mikeferguson/maxwell/README.md

## Maxwell
Maxwell is a custom mobile manipulator based on the Etherbotix
(earlier versions were based on the ArbotiX RoboController).

Documentation can be found at http://ros.org/wiki/maxwell
