mikeferguson/maxwell/maxwell/docs/lasercut/README.md

# Revision History

 * Rev. A (January 2011)
   * This is a minor revision over the original design, so that the
     front panel can drop down.
 * Rev. B (October 2014)
   * Add front panel mounts for Etherbotix, power board, torso driver.
   * Add finger holes to front panel.
   * Remove terminal block holes in bottom.
