mikeferguson/maxwell/maxwell/docs/bom.md

# Maxwell Parts List

## Purchased Components

Components for the mobile base:

Line|Qty | Description                        | Est. Cost | Notes / Vendor
----|----|------------------------------------|-----------|-------
1   |1   | Drive motors, casters, encoder cables | $309.95 | Only the motors, encoders, and casters are used. Be sure to select the 2X speed option and also add the HEDS5500 encoder cables. [Zagros Robotics](http://www.zagrosrobotics.com/shop/item.aspx?itemid=529)
2   |2   | Drive wheel | $6.80 | Any of the three colors will do. [Banebots](http://banebots.com/c/WHB-HS4-498)
3   |2   | Hub, hex, 6mm bore | $4.50 | These are 6mm and will need to be bored out to 1/4" to match motors above. [Banebots](http://banebots.com/pc/WHB-HM-HS4-M6/T40H-SM62)
4   |4   | 1/4-20 x 1-1/2" Hex Standoff | $2.02 | Used to attach caster to base. [McMaster](http://www.mcmaster.com/#91780a974/=u4mzp8)
5   |1   | UB1280 12V 8AH SLA | ~$20 | Available from Amazon among others.
6   |1   | Motor driver | $59.95 | Motor driver plugs into Etherbotix. [Pololu](http://www.pololu.com/product/708)
7   |1   | Mini-IMU9 | $19.95 | IMU, plugs into Etherbotix. [Pololu](http://www.pololu.com/product/2468)
8   |1   | Torso motor driver | $27.95 | Used for torso lift. [Pololu](http://www.pololu.com/product/705)
9   |1   | Power switch DPDT | $3.99 | [Radio Shack](http://www.radioshack.com/product/index.jsp?productId=2062518)
10  |1   | 12V snap in blue bulb | 2.99 | [Radio Shack](http://www.radioshack.com/product/index.jsp?productId=2062368)
11  |1   | Size M Charge inlet | $3.49 | [Radio Shack](http://www.radioshack.com/product/index.jsp?productId=2102486). Charge block needs to be reterminated with [Size M DC Plug](http://www.radioshack.com/product/index.jsp?productId=2103614).
12  |1   | Size N Power inlet | $3.49 | 2.5mm I.D. power jack. Matches bioloid power brick. [Radio Shack](http://www.radioshack.com/product/index.jsp?productId=2102489)
13  |18  | 4-40 right angle bracket | $6 total | These are used to assemble the base. [Digikey](http://www.digikey.com/product-search/en/hardware-fasteners-accessories/mounting-brackets/2097394?k=621K-nd)
14  |48  | 4-40 x 1/4" SHCS | $4.35 (100pk) | (24) Used to assemble base. (22) To mount Etherbotix, etc. (2) for runstop bracket. [Lynxmotion](http://www.lynxmotion.com/p-135-steel-socket-head-screws-14-x-4-40-100.aspx)
15  |12  | 4-40 x 3/8" SHCS | $4.85 (100pk) | (12) Used to attach top of base. [Lynxmotion](http://www.lynxmotion.com/p-136-steel-socket-head-screws-38-x-4-40-100.aspx)
16  |4   | 4-40 x 5/8" SHCS | $5.85 (100pk) | Used to install upright holder to base. [Lynxmotion](http://www.lynxmotion.com/p-138-steel-socket-head-screws-58-x-4-40-100.aspx)
17  |4   | 4-40 Machine Screw Nut | $0.81 (100pk) | Used to install upright holder to base. [McMaster](http://www.mcmaster.com/#90480a005/=u4n2oa)
18  |4   | 4-40 Lock Washer | $2.29 (100pk) | Used to install upright holder to base. [McMaster](http://www.mcmaster.com/#95584a200/=u4n3cc)
19  |11  | 3/8" 4-40 Standoff | $4.85 (10pk) | (4) Used to mount Etherbotix, (4) for power board and (3) for torso motor driver. [Lynxmotion](http://www.lynxmotion.com/p-152-nylon-hex-standoffs-f-f-38-x-14-4-40-tapped-10.aspx)

Components for the Torso and Head:

Line|Qty | Description                        | Est. Cost | Notes / Vendor
----|----|------------------------------------|-----------|-------
20  |1   | 20" Linear actuator| $119.99 | Torso lift actuator. [Firgelli](http://www.firgelliauto.com/product_info.php?cPath=118&products_id=255)
21  |2   | Actuator mount | $7.00 | Only bracket is used, hardware is replaced. [Firgelli](http://www.firgelliauto.com/product_info.php?products_id=54)
22  |2   | 1/4-20 x 1.5" Bolt w/ Nut | ??? | For attaching linear actuator to mounts.
23  |2   | 8020 1010x36 T Slot Aluminum Extrusion | ~$10 | The 8020 Ebay store can be a good place to buy this and other 8020 components. The bottom piece will be un-cut, 36" long. The top piece used for Maxwell's torso will need to be cut to 14" long.
24  |2   | 8020 Corner Bracket P/N 4108 | $2.75 | Used to hold torso upright.
25  |1   | 8020 Joining Strip P/N 4117 | $5 | Attaches upper and lower 8020 sections.
26  |1   | 8020 3/8" Bolt, T Nuts (25) P/N 3386 | $11.50 | (2) for corner bracket upright portion, (4) for joining plate, (2) for mounting linear actuator.
27  |1   | 8020 1/2" Bolt, T Nuts (25) P/N 3321 | $12.50 | (4) for mounting estop assembly, (8) for mounting caster
28  |6   | 1/4-20 x 5/8" Bolt | ? | (4) for head, (2) for base.
29  |2   | 1/4-20 Nut | ? | (2) used to attach corner bracket 4108 to base.
30  |1   | Run stop switch | $27.30 | [Digikey](http://www.digikey.com/product-search/en?Cat=1114209&k=Z1504-ND)
31  |1   | 1.25"L 4-40 Standoff | ? | Holds runstop bracket together.
32  |1   | Bioloid F2 | $1.49 | Used in head tilt. [Trossen Robotics](http://www.trossenrobotics.com/store/p/6180-Bioloid-Frame-F2.aspx)
33  |7   | Bioloid F3 | $1.49 | (2) used to attach head pan servo to neck brackets, (1) used to attach pan and tilt servos, (4) used in gripper. [Trossen Robotics](http://www.trossenrobotics.com/store/p/6181-Bioloid-Frame-F3.aspx)
34  |1   | ASUS Xtion Pro Live | $169.99 | Head sensor. [Newegg](http://www.newegg.com/Product/Product.aspx?Item=N82E16826785030)

Components for the Arm:

Line|Qty | Description                        | Est. Cost | Notes / Vendor
----|----|------------------------------------|-----------|-------
35  |3   | Dynamixel AX-12 | $44.90 | (2) in head, (1) for wrist roll. [Trossen Robotics](http://www.trossenrobotics.com/dynamixel-ax-12-robot-actuator.aspx)
36  |5   | Dynamixel MX-64T | $299.90 | Used in arm. [Trossen Robotics](http://www.trossenrobotics.com/p/mx-64t-dynamixel-robot-actuator.aspx)
37  |1   | FR05-H101K | $29.90 | Hinge kit used for wrist flex. [Trossen Robotics](http://www.trossenrobotics.com/p/Robotis-Dynamixel-FR05-H101K-Hinge-Frame-Set.aspx)
38  |2   | HN05-I101 Idler | $15.40 | Needed for upper arm MX-64 servos. [Trossen Robotics](http://www.trossenrobotics.com/p/Robotis-Dynamixel-HN05-I101-Idler-Bearing-Set.aspx)
39  |3   | FR05-S101K Side Frame | $14.90 | Used for arm pan. [Trossen Robotics](http://www.trossenrobotics.com/p/Robotis-Dynamixel-FR05-S101K-Side-Frame-Set.aspx)
40  |4   | 8020 White Unibearing Pad 6705 | $3.00 | Support bearings for the arm trolley.
41  |8   | 10-32 Flat Head, 3/4"L | ??? | Used to attach support bearings to laser cut arm trolley parts.
42  |2   | M5 x 8mm SHCS | $5.95 (50pk) | Used to attach arm trolley to linear actuator. [McMaster](http://www.mcmaster.com/#91274a125/=u4n45c)
??  |2   | 1-1/2"L 4-40 Standoff | ? | Holds trolley sides together on backside of torso.

The following parts are components of the Gen 1 gripper:

Line|Qty | Description                        | Est. Cost | Notes / Vendor
----|----|------------------------------------|-----------|-------
43  |2   | Dynamixel AX-12 | $44.90 ea. | One servo for each finger. [Trossen Robotics](http://www.trossenrobotics.com/dynamixel-ax-12-robot-actuator.aspx)
44  |2   | Bioloid F1 | $1.49 | Used in gripper. [Trossen Robotics](http://www.trossenrobotics.com/store/p/6179-Bioloid-Frame-F1.aspx)
45  |2   | Bioloid F6 | $1.49 ea. | Used to attach to wrist roll. [Trossen Robotics](http://www.trossenrobotics.com/store/p/6184-Bioloid-Frame-F6.aspx)
46  |2   | Bioloid F9 | $1.49 ea. | Used in fingers. [Trossen Robotics](http://www.trossenrobotics.com/store/p/6187-Bioloid-Frame-F9.aspx)
47  |2   | Bioloid F11 | $1.49 ea. | Used in fingers. [Trossen Robotics](http://www.trossenrobotics.com/store/p/6189-Bioloid-Frame-F11.aspx)

Optional components (or use your own wiring):

Line|Qty | Description                        | Est. Cost | Notes
----|----|------------------------------------|-----------|-------
49  |1   | Jumper wires F-F | $12.49 | Recommended way of easily connecting torso lift motor controller to Etherbotix. [Pololu](http://www.pololu.com/product/1700)
49  |18  | Wire Pin Connectors | $0.28 | Recommended for terminating wires into terminal blocks. [Digikey](http://www.digikey.com/scripts/DkSearch/dksus.dll?Detail&itemSeq=158992935)
50  |1   | 16ga Wire, 25ft (black) | $5.20 | For power wiring. [Home Depot](http://www.homedepot.com/p/Southwire-25-ft-16-Gauge-Primary-Wire-Black-55666621/202316512)
51  |1   | 16ga Wire, 25ft (white) | $5.20 | For power wiring. [Home Depot](http://www.homedepot.com/p/Southwire-25-ft-16-Gauge-Primary-Wire-White-55667921/202316509)
52  |1   | Long dynamixel wire (length?) | ? | For arm
53  |1   | Long dynamixel wire (length?) | ? | For head

## Custom Components

The Etherbotix is not currently available from retailers, but is entirely open source.
Cost of parts is approximately $60 plus PCB.

Similarly, the power board is not currently retailed, but is open source. It is very easy
to assemble. The PCB is less than 5x5cm, meeting the requirements for the cheapest
board options at Seeedstudio and others. Parts list for the power board is:

Qty | Description                        | Est. Cost | Notes / Vendor
----|------------------------------------|-----------|-------
1   | Maxwell Power Board                | 5.00      | Bare PCB
1   | Terminal Block 2P, Orange          | 0.55      | Digikey 281-2888-ND
1   | Terminal Block 2P, Black           | 0.55      | Digikey 281-1882-ND
1   | Terminal Block 3P, Orange          | 0.77      | Digikey 281-2882-ND
1   | Terminal Block 3P, Black           | 0.77      | Digikey 281-1883-ND 
1   | (optional) 19V regulator for NUC   | $16.95    | [Pololu](http://www.pololu.com/product/2571)
1   | (optional) Size N DC Power Plug | $3.99 | Matches power plug on NUC. [Radio Shack](http://www.radioshack.com/product/index.jsp?productId=2102488)

Finally, there are a number of laser cut and 3d printed components. The 3d printed
components include:

Qty | Description           | Filename or link  | Notes
----|-----------------------|-------------------|--------
1   | Upper arm bracket long | upper_arm_bracket_long.stl | Used between shoulder lift and upper arm roll servos.
1   | Upper arm bracket | upper_arm_bracket.stl | Used between upper arm roll and elbow flex servos.
1   | Head sensor mount | head_sensor_mount.stl | Mounts Asus to bioloid hinge bracket.
1   | Torso lift photointerrupter flag | ? | Snaps onto linear actuator screw, rotates through photointerrupter.
1   | Torso lift photointerrupter mount | ? | Holds photointerrupter into opening in side of linear actuator.

Laser cut components are split into 3 sheets, one each in 1/8", 3/16" and 1/4"
thickness, which should all be cut from ABS.

The 1/8" sheet contains:
 * 1 - Left neck side
 * 1 - Right neck side
 * 1 - Left runstop side
 * 1 - Right runstop side
 * 2 - Runstop spacer
 * 1 - Runstop mount plate
 * 2 - Forearm side panel
 * 2 - Gripper joining plate
 * 2 - Arm lift spacer

The 3/16" sheet contains:
 * 2 - Arm lift mounting plate
 * 2 - Arm lift servo mounting plate
 * 1 - Base front panel
 * 1 - Base left side
 * 1 - Base right side
 * 1 - Base rear panel

The 1/4" sheet contains:
 * 1 - Left neck spacer
 * 1 - Right neck spacer
 * 1 - Base top plate
 * 1 - Base upright holder
