mikeferguson/maxwell/maxwell/docs/lasercut/3_16.dxf

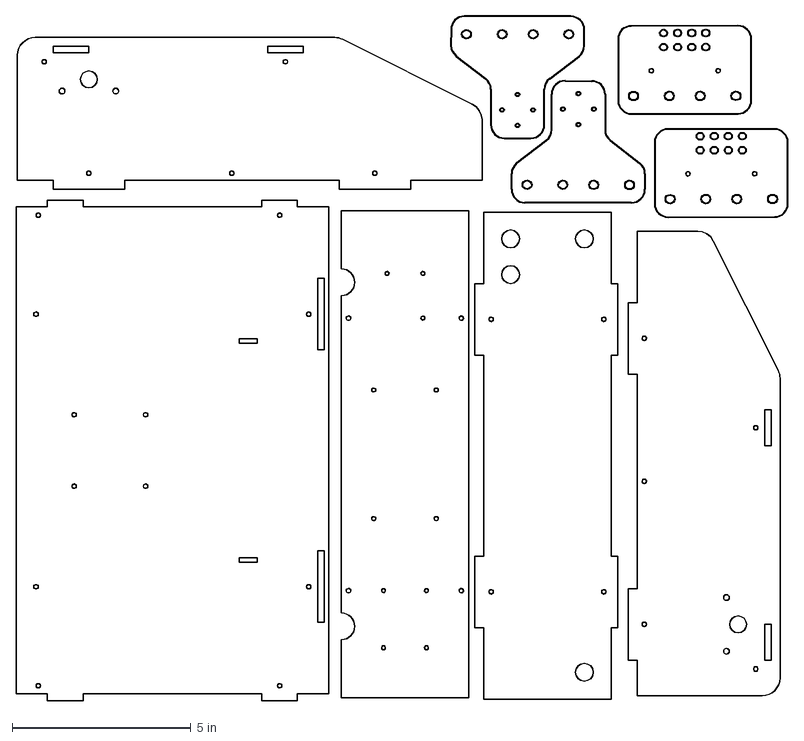
[picture p1: CAD file, 2015-01-01]
maxwell/docs/lasercut/3_16.dxf
21.6 x 19.1 in
