mikeferguson/maxwell/maxwell/docs/printed/rotary_interrupter.stl

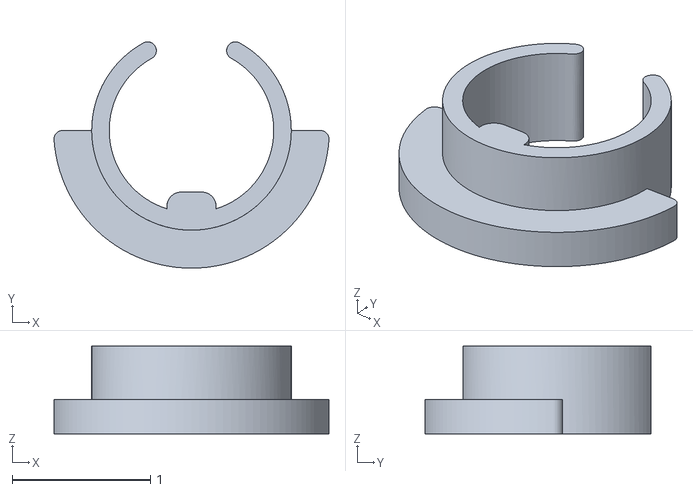
[picture p2: CAD file, 2015-03-03]
maxwell/docs/printed/rotary_interrupter.stl
1.99 x 1.64 x 0.635
