mikeferguson/maxwell/maxwell/meshes/sixdof_bracket2.stl

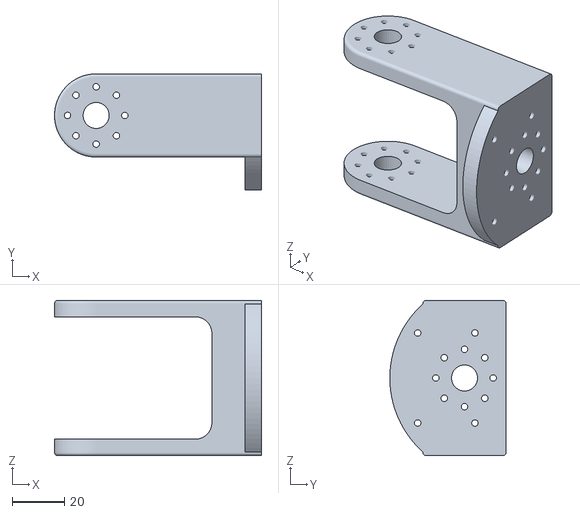
[picture p3: CAD file, 2013-02-20]
maxwell/meshes/sixdof_bracket2.stl
79.5 x 44.7 x 59.7
