mikeferguson/maxwell/maxwell/docs/lasercut/1_8.dxf

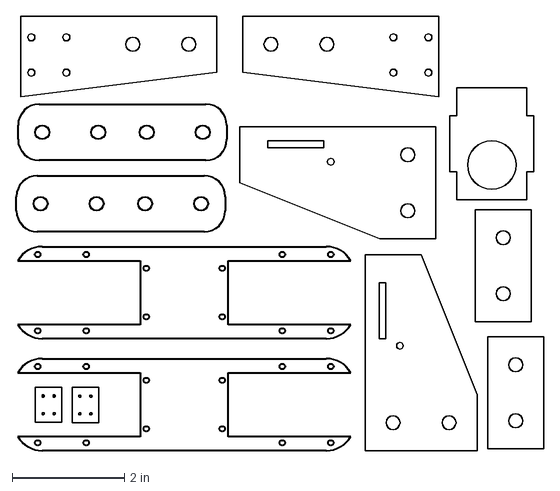
[picture p4: CAD file, 2014-12-15]
maxwell/docs/lasercut/1_8.dxf
9.42 x 7.76 in
