mikeferguson/maxwell/maxwell/docs/printed/interrupter_mount.stl

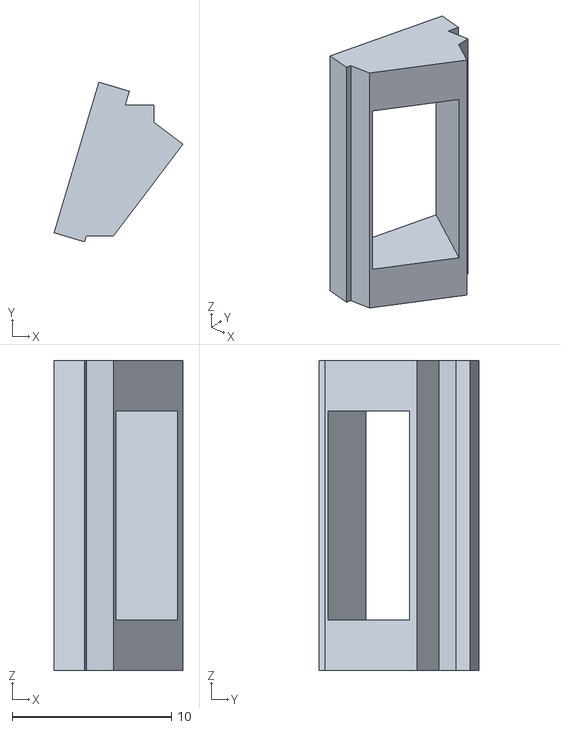
[picture p5: CAD file, 2015-03-03]
maxwell/docs/printed/interrupter_mount.stl
8.09 x 10.0 x 19.5
