mikeferguson/maxwell/maxwell/meshes/sixdof_bracket1.stl

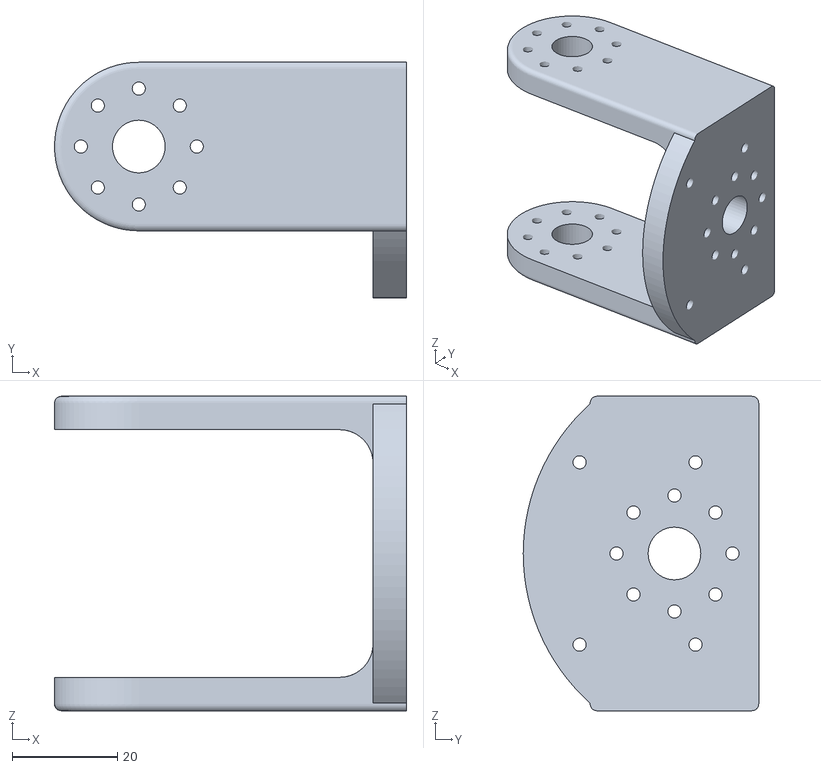
[picture p6: CAD file, 2013-02-20]
maxwell/meshes/sixdof_bracket1.stl
66.8 x 44.7 x 59.7
