mikeferguson/maxwell/maxwell/docs/lasercut/1_4.dxf

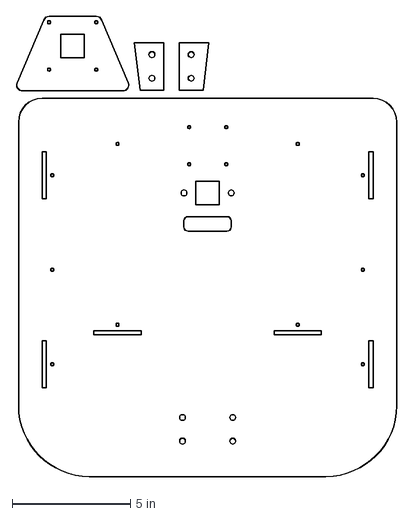
[picture p7: CAD file, 2014-10-19]
maxwell/docs/lasercut/1_4.dxf
16.1 x 19.5 in
