mikeferguson/maxwell/maxwell/docs/printed/wrist_mount.stl

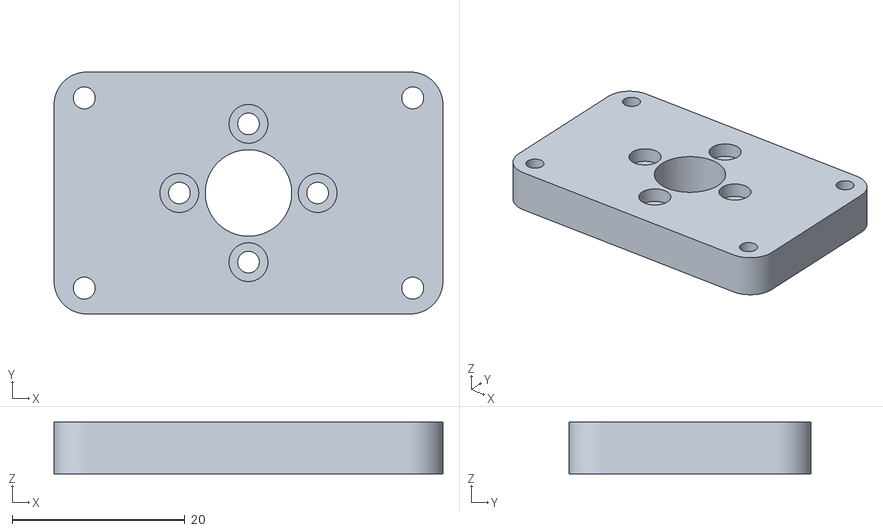
[picture p8: CAD file, 2014-12-14]
maxwell/docs/printed/wrist_mount.stl
45.0 x 28.0 x 6.00
