mikeferguson/maxwell/maxwell/meshes/ax12.stl

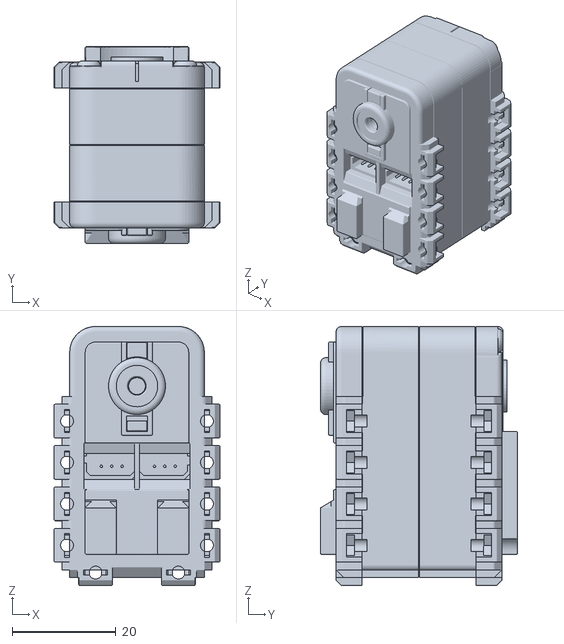
[picture p9: CAD file, 2013-02-02]
maxwell/meshes/ax12.stl
32.0 x 38.0 x 50.0
