mikeferguson/maxwell/maxwell/docs/printed/upper_arm_bracket_long.stl

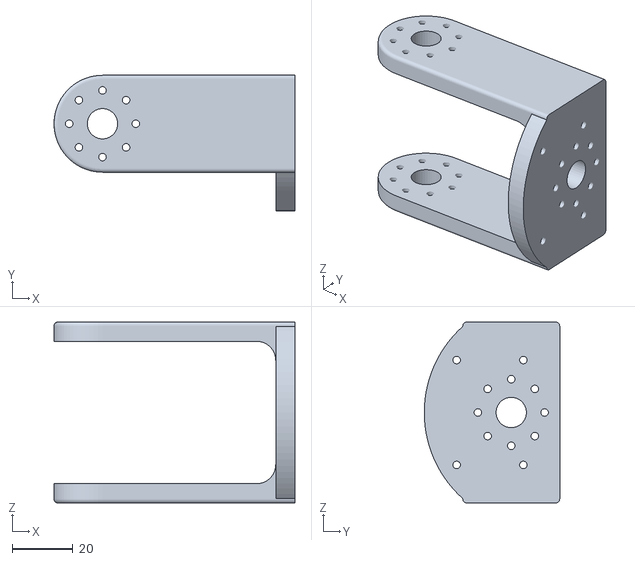
[picture p10: CAD file, 2014-10-19]
maxwell/docs/printed/upper_arm_bracket_long.stl
79.5 x 44.7 x 59.7
