mikeferguson/maxwell/maxwell/meshes/rx64.stl

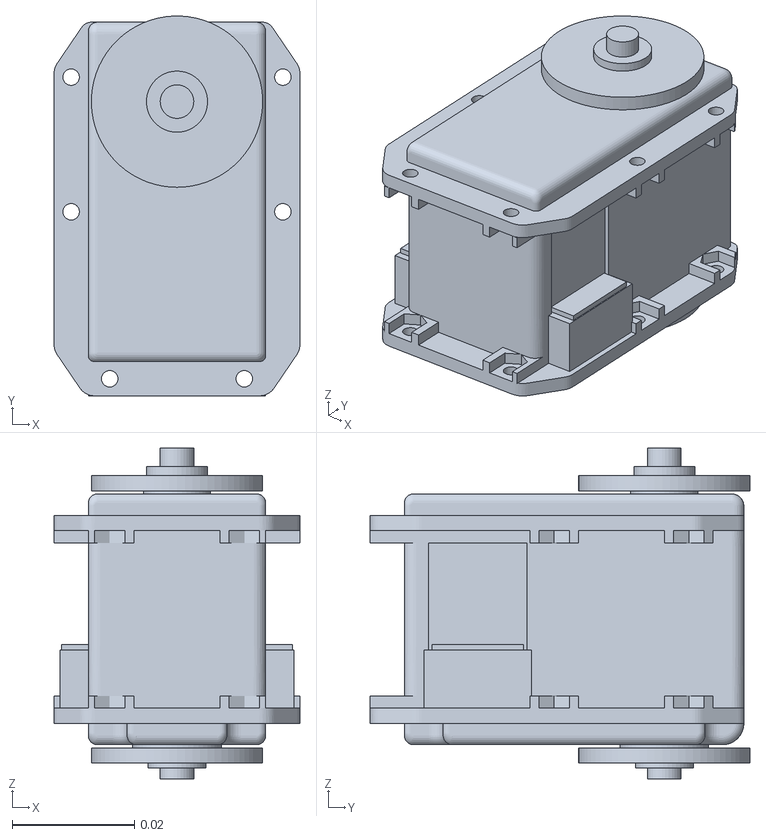
[picture p11: CAD file, 2013-02-02]
maxwell/meshes/rx64.stl
0.0402 x 0.0621 x 0.0541
