mikeferguson/maxwell/maxwell/docs/printed/head_sensor_mount.stl

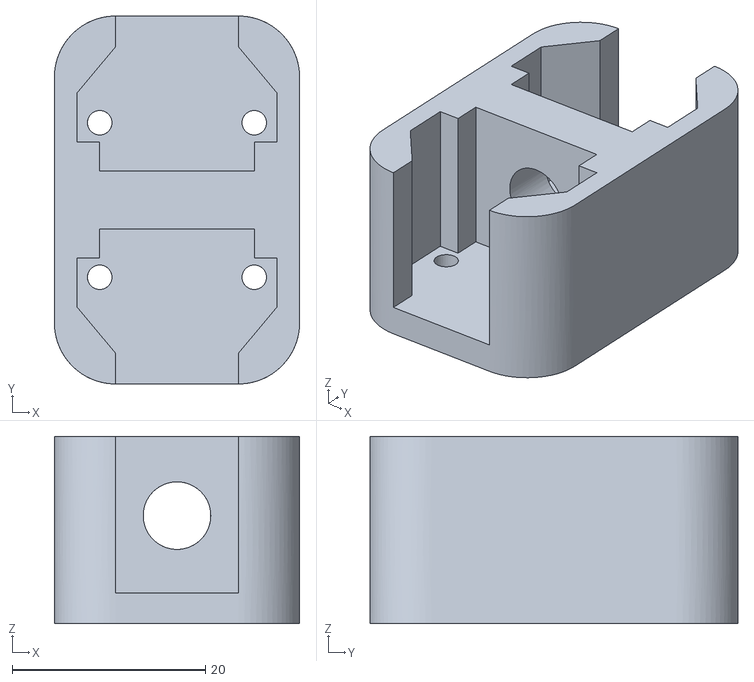
[picture p12: CAD file, 2014-10-19]
maxwell/docs/printed/head_sensor_mount.stl
25.4 x 38.1 x 19.4
