mikeferguson/maxwell/maxwell/meshes/rx64-side-bracket.stl

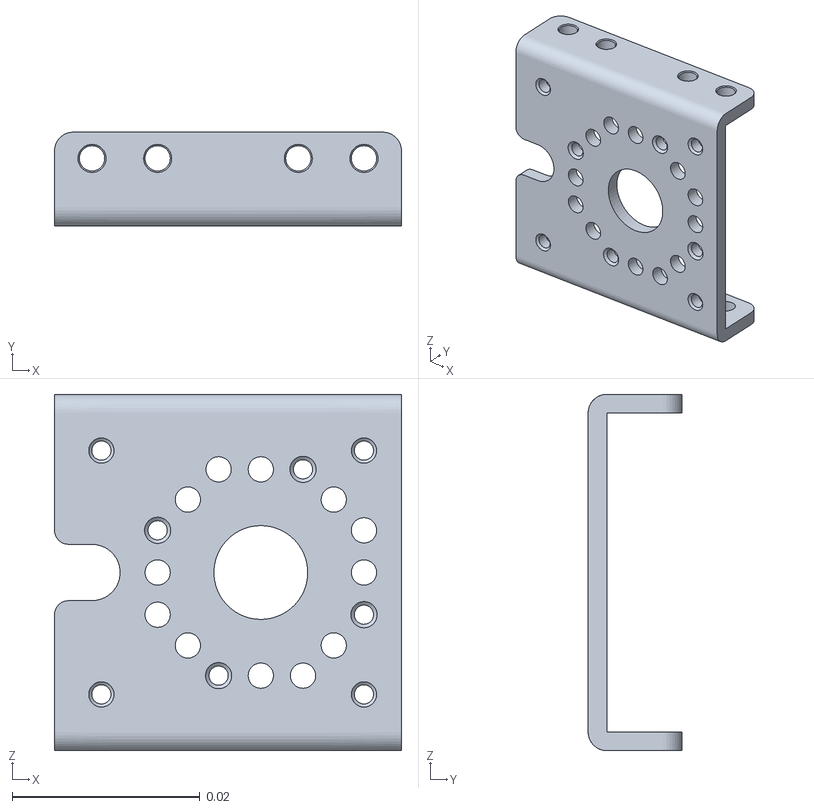
[picture p13: CAD file, 2013-02-02]
maxwell/meshes/rx64-side-bracket.stl
0.037 x 0.01 x 0.038
