mikeferguson/maxwell/maxwell/meshes/arm_mount_28.stl

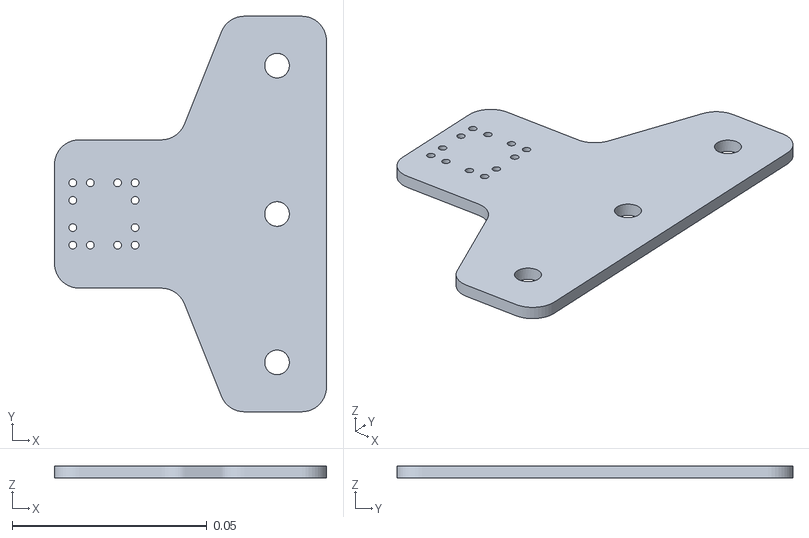
[picture p14: CAD file, 2013-02-02]
maxwell/meshes/arm_mount_28.stl
0.0698 x 0.102 x 0.00305
