mikeferguson/maxwell/maxwell/meshes/arm_mx64_forearm.stl

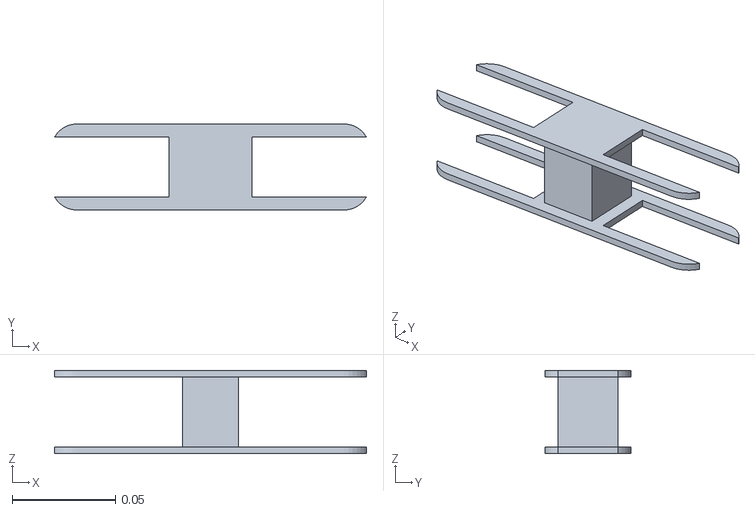
[picture p15: CAD file, 2013-02-02]
maxwell/meshes/arm_mx64_forearm.stl
0.151 x 0.0417 x 0.0404
