mikeferguson/maxwell/maxwell/meshes/rx28-side-bracket.stl

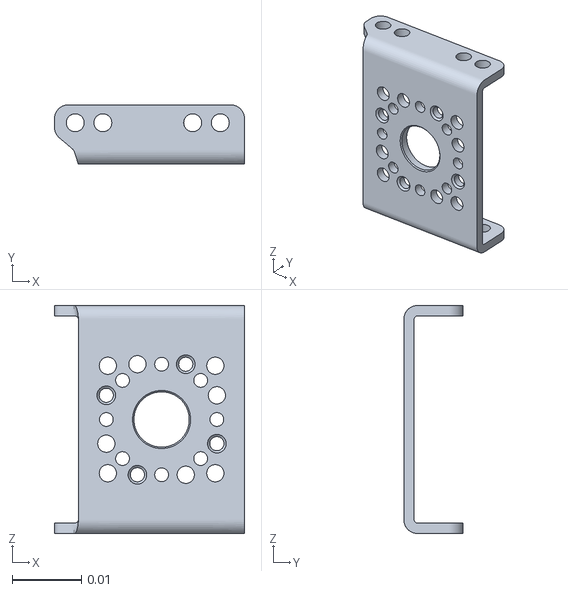
[picture p16: CAD file, 2013-02-02]
maxwell/meshes/rx28-side-bracket.stl
0.0275 x 0.0086 x 0.033
