mikeferguson/maxwell/maxwell/meshes/base.stl

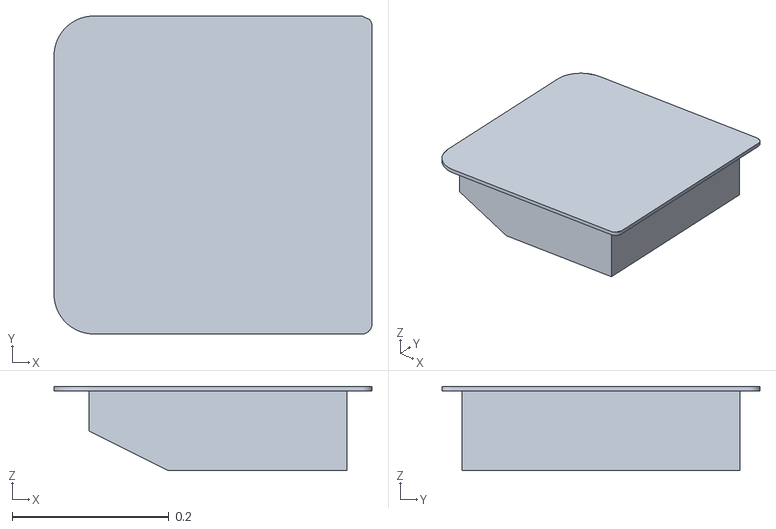
[picture p17: CAD file, 2013-02-02]
maxwell/meshes/base.stl
0.406 x 0.406 x 0.108
