mikeferguson/maxwell/maxwell/meshes/F9.stl

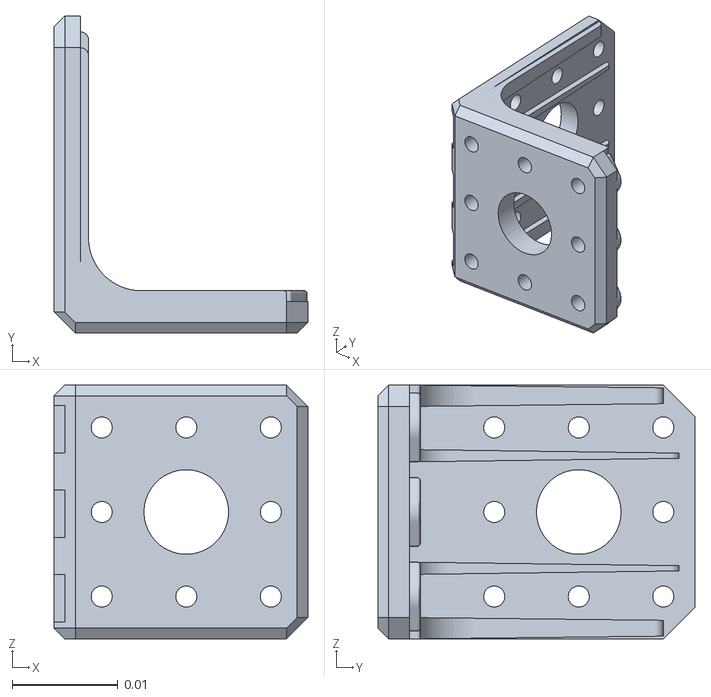
[picture p18: CAD file, 2013-02-02]
maxwell/meshes/F9.stl
0.024 x 0.03 x 0.024
