mikeferguson/maxwell/maxwell/meshes/rx28.stl

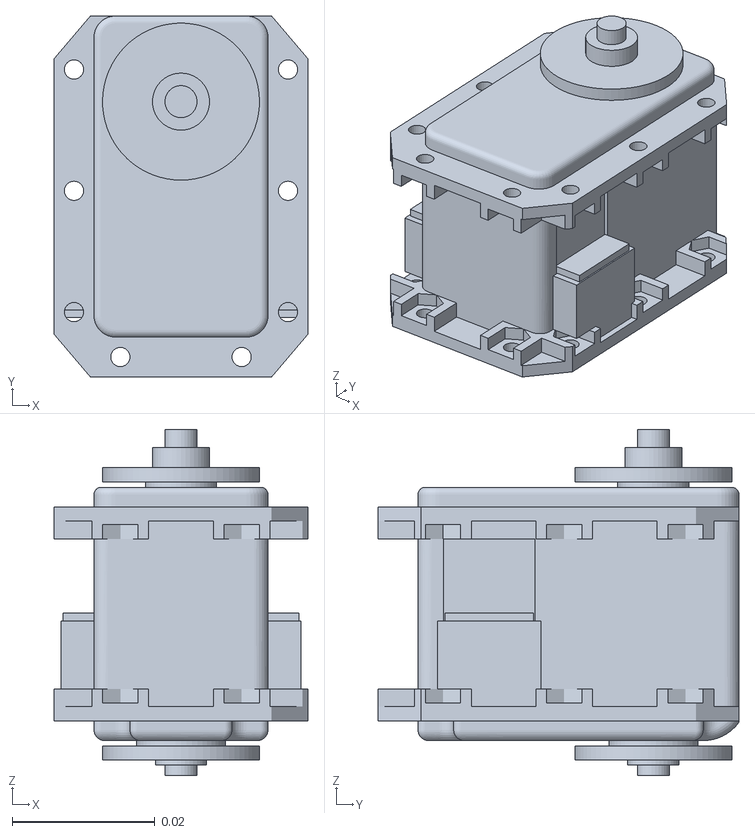
[picture p19: CAD file, 2013-02-02]
maxwell/meshes/rx28.stl
0.0356 x 0.0506 x 0.0485
