mikeferguson/maxwell/maxwell/meshes/arm_mx64_upper.stl

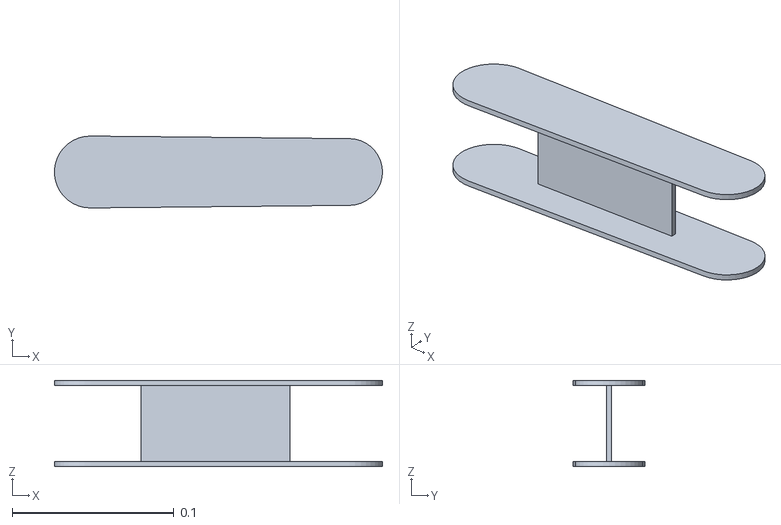
[picture p20: CAD file, 2013-02-02]
maxwell/meshes/arm_mx64_upper.stl
0.203 x 0.0444 x 0.0534
