mikeferguson/maxwell/maxwell/meshes/rx64-hxl.stl

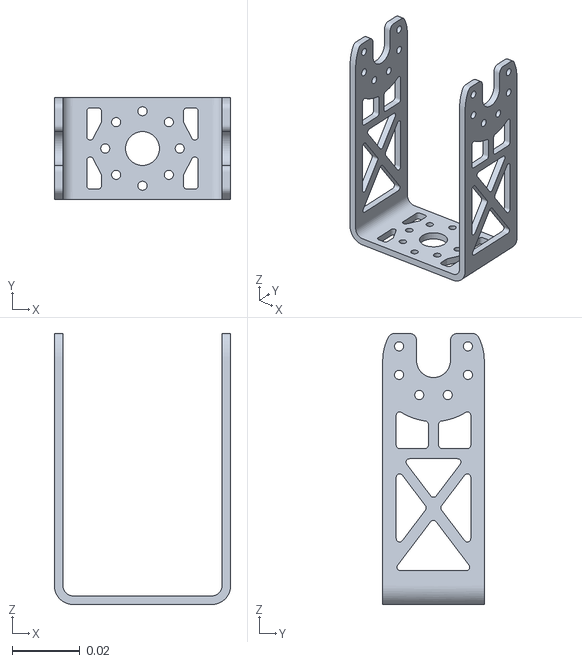
[picture p21: CAD file, 2013-02-02]
maxwell/meshes/rx64-hxl.stl
0.0521 x 0.03 x 0.08
