mikeferguson/maxwell/maxwell/meshes/rx28-hinge-bracket.stl

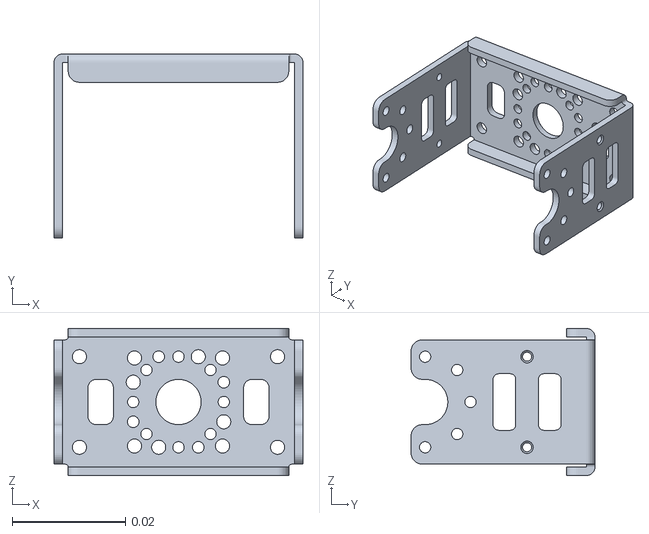
[picture p22: CAD file, 2013-02-02]
maxwell/meshes/rx28-hinge-bracket.stl
0.044 x 0.0325 x 0.026
