mikeferguson/maxwell/maxwell/meshes/F3.stl

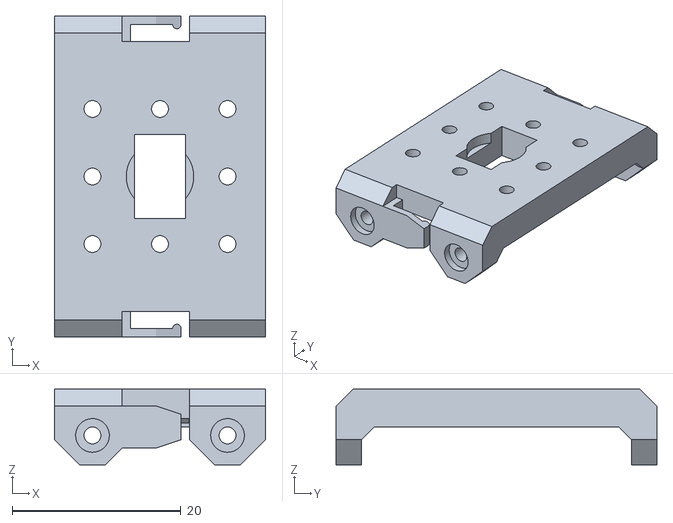
[picture p23: CAD file, 2013-02-02]
maxwell/meshes/F3.stl
25.0 x 38.0 x 9.00
