mikeferguson/maxwell/maxwell/meshes/rx64-hinge-bracket.stl

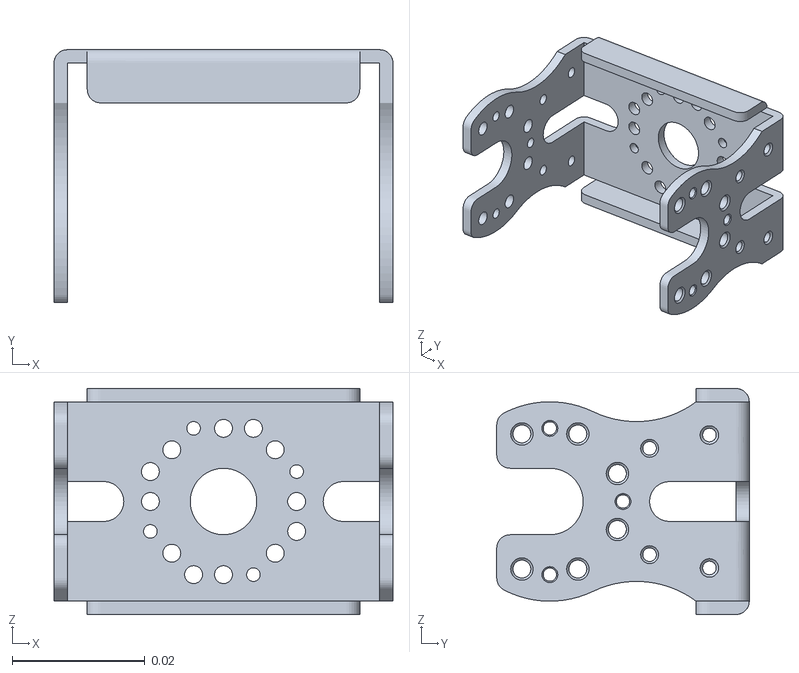
[picture p24: CAD file, 2013-02-02]
maxwell/meshes/rx64-hinge-bracket.stl
0.051 x 0.038 x 0.034
