mikeferguson/maxwell/maxwell/meshes/arm_mount.stl

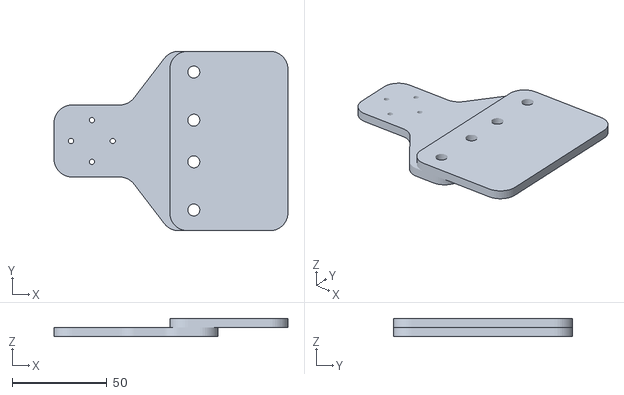
[picture p25: CAD file, 2013-02-02]
maxwell/meshes/arm_mount.stl
123.5 x 94.7 x 9.52
