mikeferguson/maxwell/maxwell/meshes/F11.stl

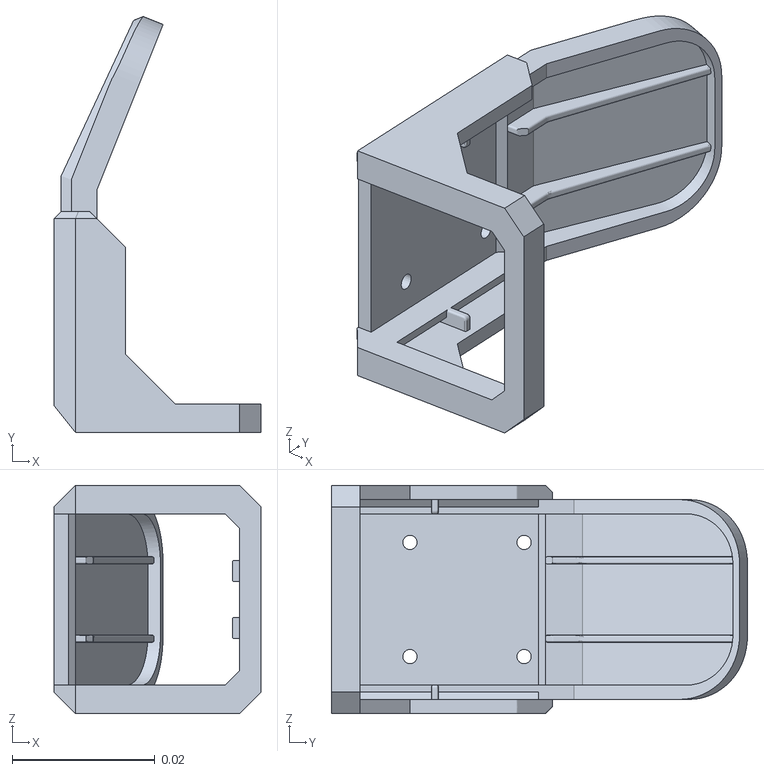
[picture p26: CAD file, 2013-02-02]
maxwell/meshes/F11.stl
0.029 x 0.0583 x 0.032
