mikeferguson/maxwell/maxwell/meshes/head_mount.stl

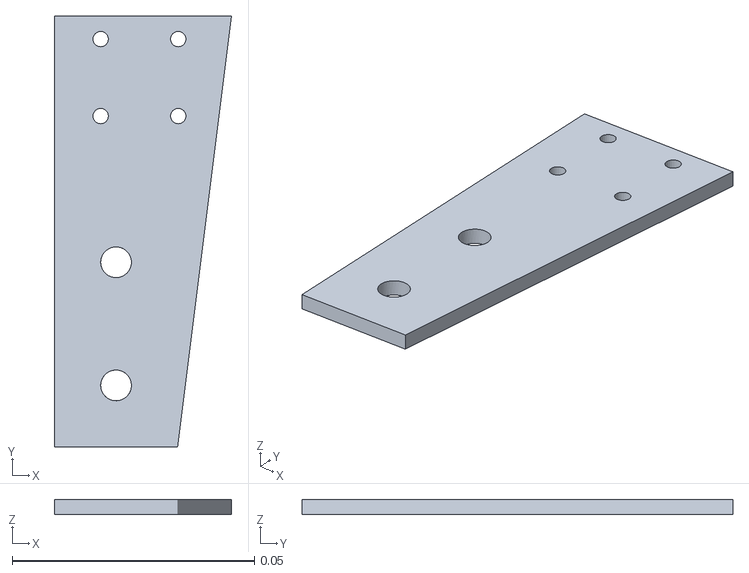
[picture p27: CAD file, 2013-02-02]
maxwell/meshes/head_mount.stl
0.0365 x 0.0889 x 0.00317
