mikeferguson/maxwell/maxwell/meshes/FA-35-TR.stl

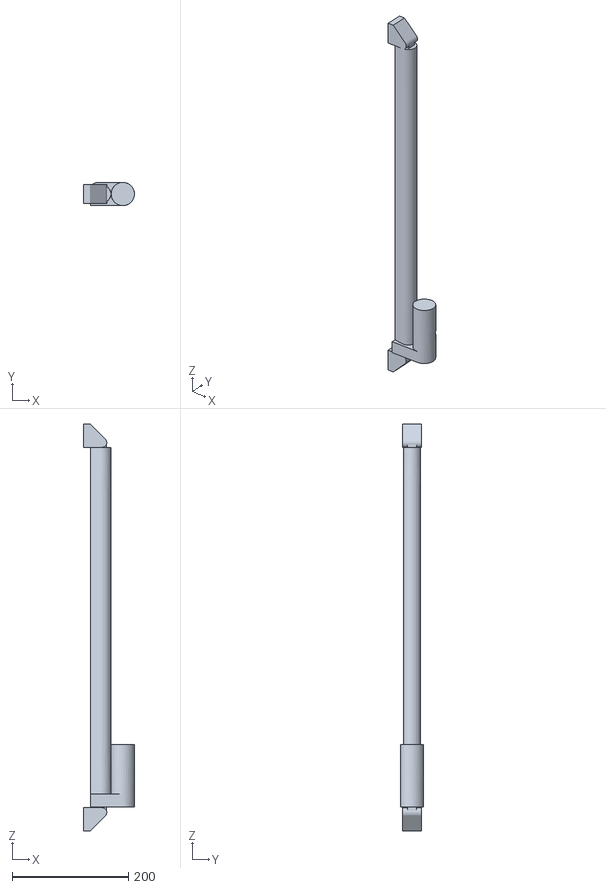
[picture p28: CAD file, 2013-02-02]
maxwell/meshes/FA-35-TR.stl
87.5 x 40.0 x 699.0
