mikeferguson/maxwell/maxwell/meshes/F6.stl

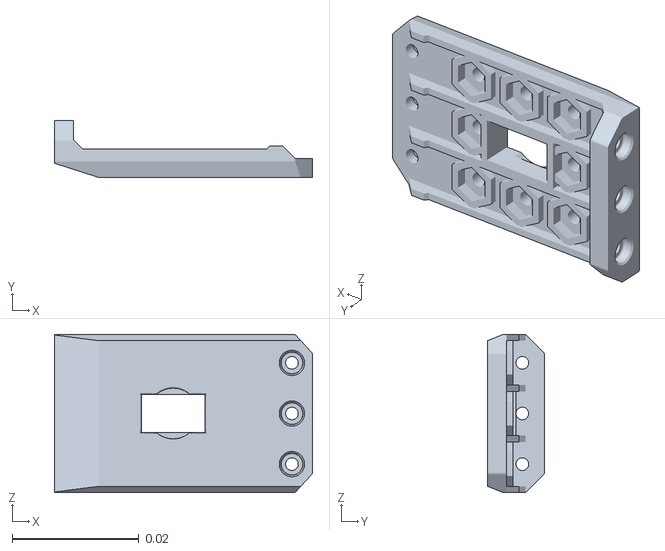
[picture p29: CAD file, 2013-02-02]
maxwell/meshes/F6.stl
0.0408 x 0.009 x 0.025
