mikeferguson/maxwell/maxwell/meshes/kinect.stl

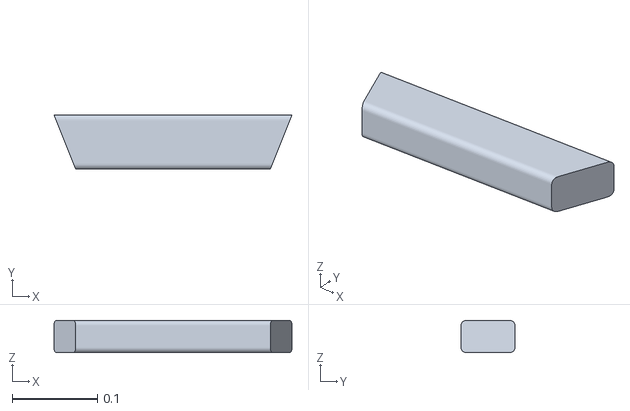
[picture p30: CAD file, 2013-02-02]
maxwell/meshes/kinect.stl
0.279 x 0.0635 x 0.0381
