mikeferguson/maxwell/maxwell/meshes/F2.stl

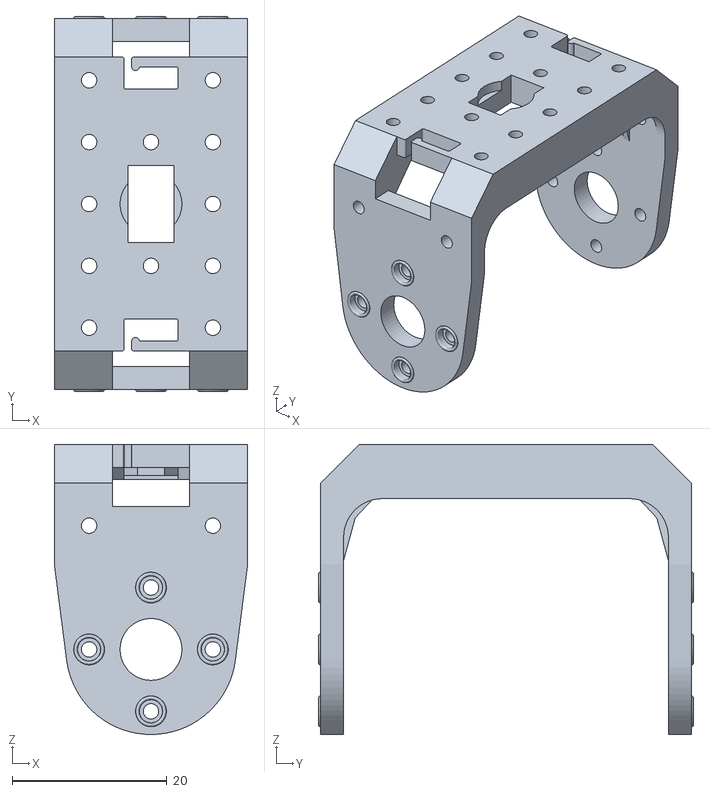
[picture p31: CAD file, 2013-02-02]
maxwell/meshes/F2.stl
25.0 x 48.5 x 37.5
