mikeferguson/maxwell/maxwell/meshes/xtion.stl

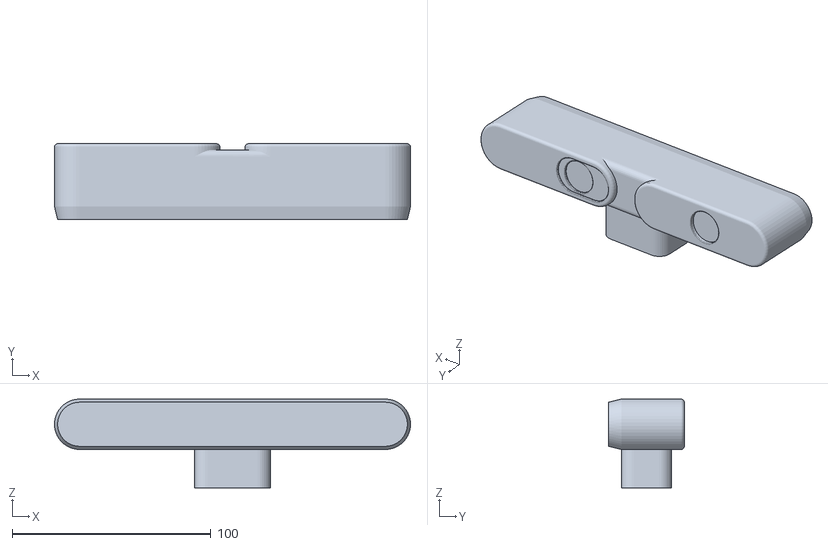
[picture p32: CAD file, 2013-02-02]
maxwell/meshes/xtion.stl
179.3 x 38.1 x 44.8
