mikeferguson/maxwell/maxwell/meshes/F1.stl

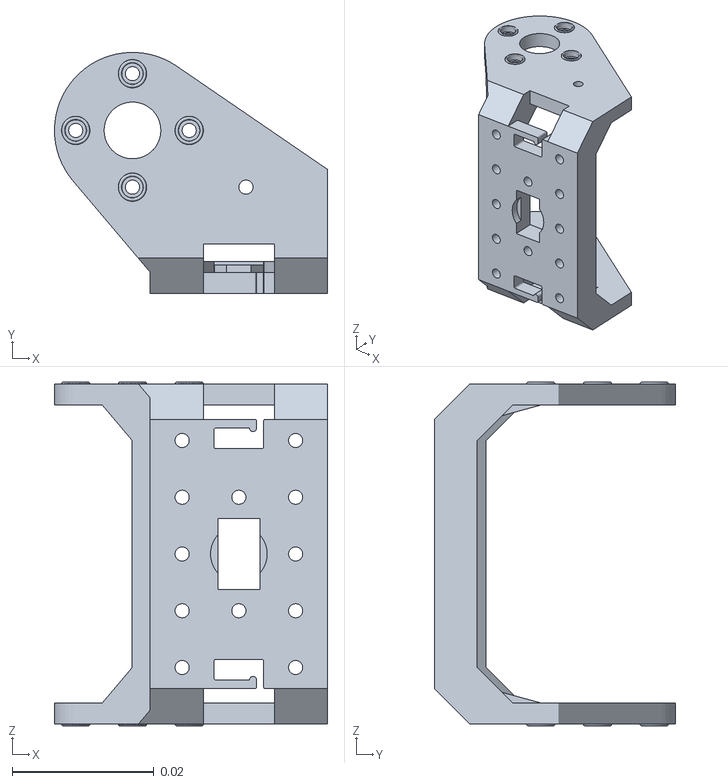
[picture p33: CAD file, 2013-02-02]
maxwell/meshes/F1.stl
0.0385 x 0.034 x 0.0485
