mikeferguson/maxwell/(threads)

Thread 5 (2014-11-18):

Issues with BOM

mikeferguson, 2014-11-18:
Issues with the BOM:
 * [x] Missing the standoffs on the arm trolley.
 * [x] Missing the standoffs for the estop.
 * [x] Part number for linear bearings appears to be wrong part (no flat side)
 * [x] Need to add lengths of the 8020

Issues with the DXFs and STLs:
 * [x] Missing STL for the wrist roll servo mount.
 * [x] Mount holes on base motors need to be enlarged.
 * [x] Estop bracket is missing holes for standoff
 * [x] Arm trolley sides are missing holes for standoffs
 * [x] Holes pattern is incorrect for the torso lift motor driver (can only be installed upside down).

mikeferguson, 2015-01-02:
Added standoff holes to trolley mount.

Closed 2015-01-02.

Thread 6 (2014-12-14):

Review URDF for correctness

mikeferguson, 2014-12-14:
While creating a BOM, several issues potentially identified:
- [x] Should arm trolley be moved forward? Mount holes are not centered on rail.
- [ ] Wrist bracket should be updated, wrist mount part is missing. Is spacing still correct?
- [x] Should update to use wrist_roll_link for manipulation, remove gripper_link

mikeferguson, 2015-01-01:
* Centered up arm trolley (cosmetic only)
 * Added 10mm to spacing of wrist flex -> wrist roll. Need to still update bracket to make this look right.
 * removed gripper link, updated moveit config

Closed 2020-06-20.

Thread 7 (2014-12-29):

Revive calibration

mikeferguson, 2014-12-29:
The calibration stuff is horribly out of date and never worked that well. I intend to update this to use my newer calibration stuff over the next couple of weeks.

jon-weisz, 2015-02-08:
Hey Mike, did you kill off the robot_geometry stuff in your old SVN repo for a reason?
I was thinking of making a simple calibration tool using the robot point cloud that is similar.

mikeferguson, 2015-02-08:
Which robot_geometry stuff?

mikeferguson, 2015-02-08:
Oh, the really old maxwell calibration stuff. Yeah, that never got finished, and then I ended up using the pr2_calibration after I removed PR2 stuff from it (that was fall of 2011 at WG). I'm now planning to end up using a generic version of the ubr_calibration (the start of it is over here: https://github.com/mikeferguson/robot_calibration), but I haven't had a ton of time to work on it.

jon-weisz, 2015-02-08:
http://vanadium-ros-pkg.googlecode.com/svn/graveyard/maxwell_calibration_old/src/robot_geometry.cpp

jon-weisz, 2015-02-08:
Yeah, I don't think this should really be on you. Calibration is really hard for beginners, and really easy to get wrong. Seems like making this stack a first class member of ROS would be really nice. Maybe we should propose it as a future OSRF SoC project?

jon-weisz, 2015-02-08:
I know ros-industrial has this stuff: https://github.com/ros-industrial/industrial_calibration/ but it isn't complete yet either.

mikeferguson, 2015-02-08:
Calibration is definitely an area that needs help in ROS -- however, having now worked on several calibration systems, I think you'd be quite hard pressed to have something that works for all situations (pr2_calibration is quite different from ubr_calibration, as the sensors are different, industrial calibration really only calibrates the camera positions as the assumption is that the mechanical system needs no calibration). Even if you could build something for all situations, I think it is a much larger project than could really be accomplished in a SoC sprint.

robot_calibration is intended for hand-eye calibration, primarily targeting kinect-like sensors, and will be getting quite a bit of work shortly, it just slid backwards in our schedule. It will certainly be done by summer, including a decent amount of documentation.

mikeferguson, 2023-12-10:
Not going to implement calibration for Maxwell, since the robot is pretty much EOL. For anyone stumbling on this, check out robot_calibration on either the Fetch or the UBR-1: https://github.com/mikeferguson/ubr_reloaded/tree/ros2/ubr1_calibration

Closed 2023-12-10.

Thread 8 (2015-01-29):

Create PDF and/or PNG of the board connections

mikeferguson, 2015-01-29:
Can probably take view of silkscreen from Eagle, and then add some color. Call out especially:
- Power/GND/Signal of A0-D7
- GND on each of aux. and power input connectors

mikeferguson, 2024-02-02:
wiring diagram PDF is sufficient

Closed 2024-02-02.

Thread 9 (2018-04-05):

Validate wiring diagram

mikeferguson, 2018-04-05:
Appears that left/right motor/encoder are swapped. Need to update the wiring diagram.

Closed 2018-04-05.

Thread 10 (2020-06-16):

ROS2 Port

mikeferguson, 2020-06-16:
Depends on digital IO and servo aspects of https://github.com/mikeferguson/etherbotix/issues/7

 * [x] Update etherbotix config to use new C++ drivers, robot_controllers
 * [ ] Port launch files
 * [x] Add controller and  joint handle for lift joint

Closed 2023-12-17.
