mikeferguson/maxwell/maxwell/docs/wiring.pdf

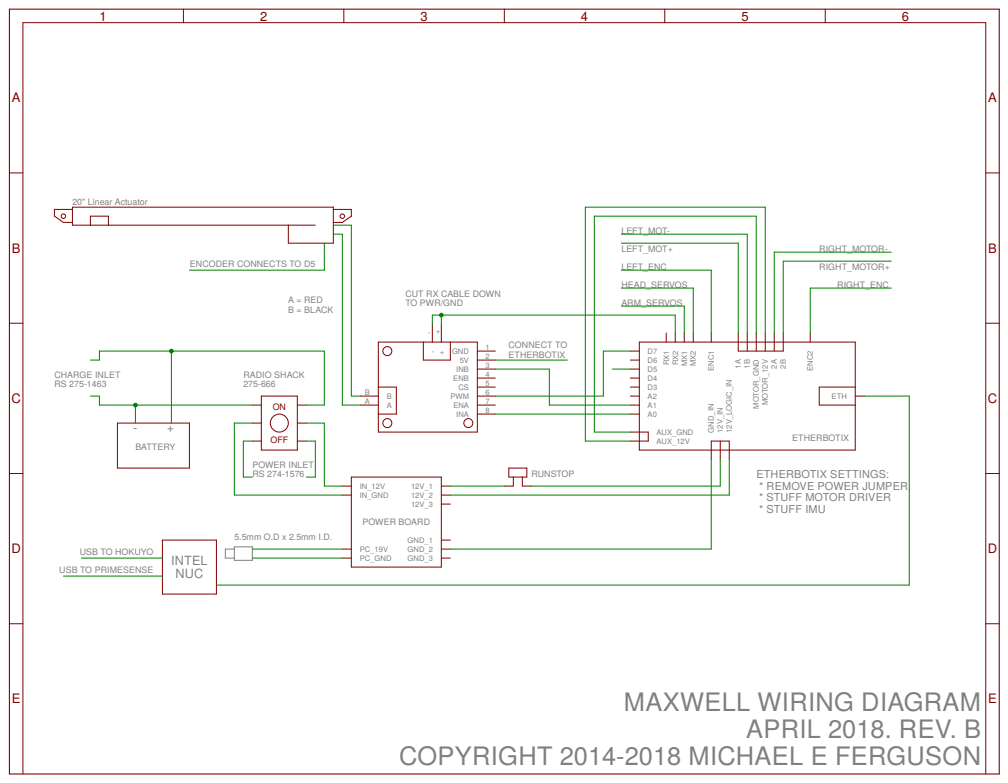
[picture p40: page 1]

CUT RX CABLE DOWN
TO PWR/GND

ETHERBOTIX SETTINGS: * REMOVE POWER JUMPER
* STUFF MOTOR DRIVER
* STUFF IMU
