mikeferguson/maxwell/maxwell/docs/powerboard.pdf

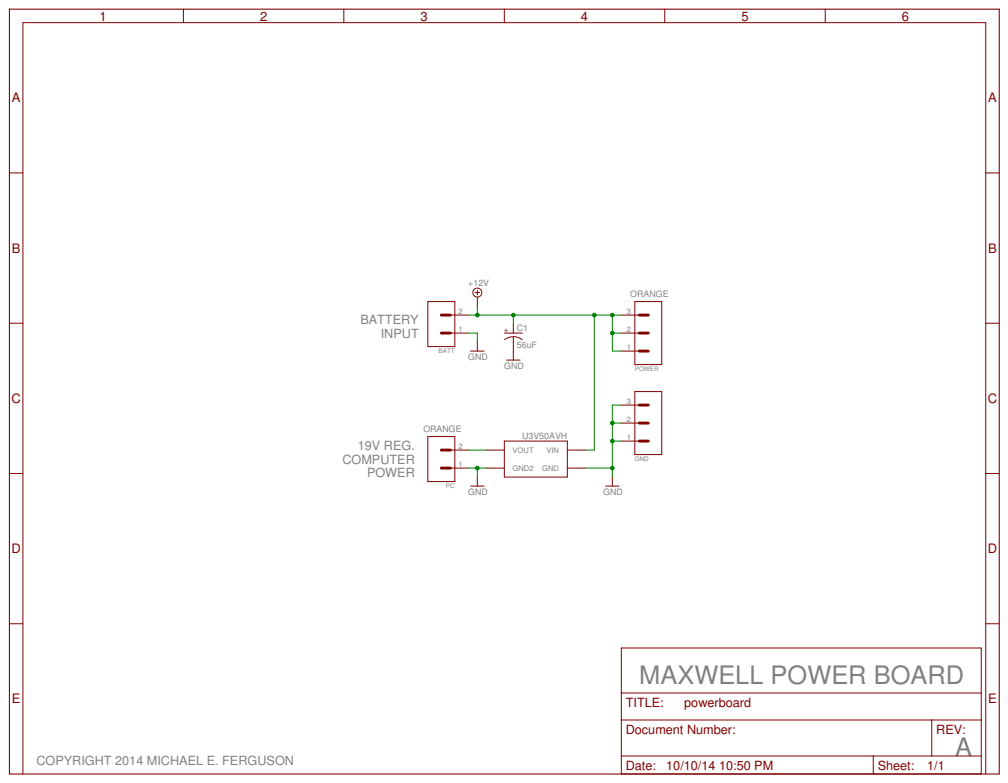
[picture p41: page 1]

Document Number: | REV:

Date: 10/10/14 10:50 PM | Sheet: 1/1
