mikeferguson/maxwell/maxwell_moveit_config/config/joint_limits.yaml

joint_limits:
  arm_elbow_flex_joint:
    has_velocity_limits: true
    max_velocity: 0.524
    has_acceleration_limits: true
    max_acceleration: 1.0
  arm_lift_joint:
    has_velocity_limits: true
    max_velocity: 0.0508
    has_acceleration_limits: true
    max_acceleration: 1.0
  arm_shoulder_lift_joint:
    has_velocity_limits: true
    max_velocity: 0.524
    has_acceleration_limits: true
    max_acceleration: 1.0
  arm_shoulder_pan_joint:
    has_velocity_limits: true
    max_velocity: 0.524
    has_acceleration_limits: true
    max_acceleration: 1.0
  arm_upperarm_roll_joint:
    has_velocity_limits: true
    max_velocity: 0.524
    has_acceleration_limits: true
    max_acceleration: 1.0
  arm_wrist_flex_joint:
    has_velocity_limits: true
    max_velocity: 0.785
    has_acceleration_limits: true
    max_acceleration: 1.0
  arm_wrist_roll_joint:
    has_velocity_limits: true
    max_velocity: 0.785
    has_acceleration_limits: true
    max_acceleration: 1.0
  l_gripper_joint:
    has_velocity_limits: true
    max_velocity: 1.0
    has_acceleration_limits: true
    max_acceleration: 1.0
  r_gripper_joint:
    has_velocity_limits: true
    max_velocity: 1.0
    has_acceleration_limits: true
    max_acceleration: 1.0
