mikeferguson/maxwell/(commit log)

2013-02-02 import and catkinize maxwell_defs
    [F1.stl, F11.stl, F2.stl, F3.stl, F6.stl, F9.stl, FA-35-TR.stl, arm.urdf.xacro]
2013-02-02 import and catkinize calibration
    [controller_config.yaml]
2013-02-02 interactive markers is building, but simple arm server is basically borked underneath
2013-02-19 need static urdf for moveit
    [maxwell.urdf]
2013-02-20 add demo launch file with joint state gui
2013-02-20 add upper arm roll joint
    [arm.urdf.xacro, sixdof_bracket1.stl, sixdof_bracket2.stl]
2013-02-20 update static urdf
    [maxwell.urdf]
2013-02-20 add moveit_config
    [joint_limits.yaml]
2013-02-21 Add upperarm roll joint to arm follow controller in maxwell_defs
2013-02-21 update maxwell_moveit_config
    [controllers.yaml]
2013-02-24 reverse long and short brackets in urdf
    [arm.urdf.xacro]
2013-02-26 fix invert flag of upper arm roll
2013-03-19 set joint limits properly
    [joint_limits.yaml]
2013-03-21 self filter working
2013-03-28 updates for moveit
    [arm.urdf.xacro]
2013-05-11 switch to using new action-based gripper controller
    [controllers.yaml]
2013-05-11 add gripper to simple moveit controller manager, still needs work
2013-05-12 add gripper_link to Gripper group, fixes some pick and place problems
2013-05-22 update exported urdf
    [maxwell.urdf]
2013-05-23 add string for type in controllers.yaml
    [controllers.yaml]
2013-05-26 make group names lower case
2013-05-30 switch to moveit_plugins controller manager
2013-07-22 update to match new action_ns parameters in plugin
    [controllers.yaml]
2013-12-05 updates for xacro deprecations in hydro
    [base.urdf.xacro, maxwell.urdf.xacro]
2014-10-17 update to new etherbotix-based hardware
    [maxwell_no_arm.xacro]
2014-10-19 update to newer drivers, fixup package.xml
2014-10-19 update gripper controller
2014-10-19 add teleop by default, revive laser after blacklisting usb_snd_audio
2014-10-19 install laser udev rule
2014-10-19 add lasercut rev. A, printed brackets
    [1_4.dxf, 1_8.dxf, 3_16.dxf, head_sensor_mount.stl, upper_arm_bracket.stl, upper_arm_bracket_long.stl]
2014-10-19 update lasercut components
    [3_16.dxf]
2014-10-22 update sensor configuration
2014-10-27 switch to using simple_teleop in etherbotix_python package
2014-12-14 enlarge base motor mounting holes
    [3_16.dxf]
2014-12-14 add wrist mount stl
    [wrist_mount.stl]
2014-12-15 add standoff holes to estop bracket
    [1_8.dxf]
2014-12-15 fix orientation of motor driver mount
    [3_16.dxf]
2015-01-01 moving towards robot_calibration
    [calibrate.yaml, controller_config.yaml]
2015-01-01 update URDF for correctness, remove gripper_link
    [arm.urdf.xacro, gripper.urdf.xacro]
2015-01-01 add standoff holes to trolley mount
    [3_16.dxf]
2015-01-02 update moveit config
    [fake_controllers.yaml, maxwell.urdf]
2015-03-03 add STL files for rotary interrupter
    [interrupter_mount.stl, rotary_interrupter.stl]
2018-04-05 update wiring diagram, closes #9
2018-04-09 update calibration to newest format
    [calibrate.yaml]
2018-06-13 update maxwell torso calibration
2018-06-15 update URDF for parallel gripper
    [maxwell.urdf.xacro, parallel_gripper.urdf.xacro]
2020-03-28 replace missing sensor bringup
2020-03-28 fix xacro warnings
    [arm.urdf.xacro, ax12.xacro, base.urdf.xacro, gripper.urdf.xacro, head.urdf.xacro, hokuyo_urg_laser.urdf.xacro, kinect_camera.urdf.xacro, maxwell.urdf.xacro]
2020-06-19 start to port to ros2
    [1_4.dxf, 1_8.dxf, 3_16.dxf, F1.stl, F11.stl, F2.stl, F3.stl, F6.stl]
2020-06-19 fixup urdf after rename
    [arm.urdf.xacro, ax12.xacro, base.urdf.xacro, head.urdf.xacro, kinect_camera.urdf.xacro, maxwell.urdf.xacro, rx28.xacro, rx64.xacro]
2020-08-23 add demo camera launch for HBRC
